SAMEER-MLPROJECT/RoTorBot/docs/figures/09_exploded.png

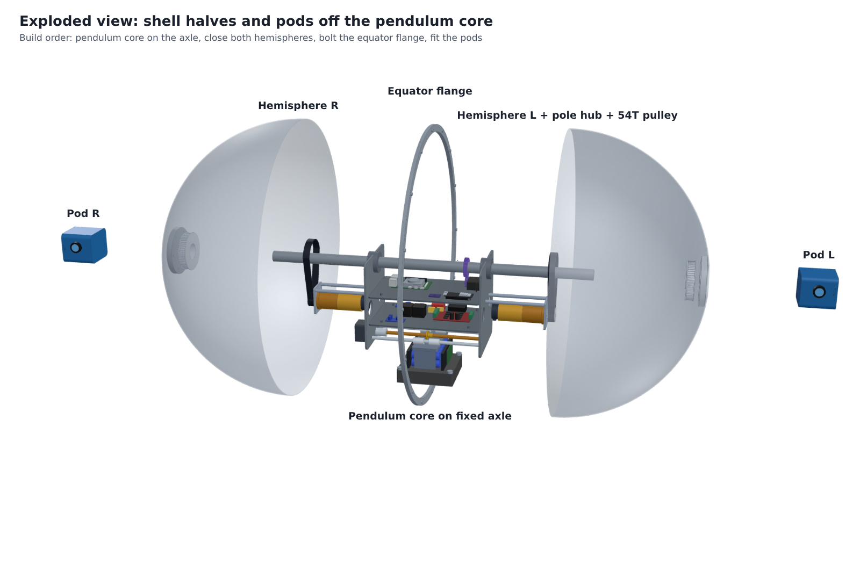
docs/figures/09_exploded.png
