SAMEER-MLPROJECT/RoTorBot/cad/RoToRBot_assembly.step

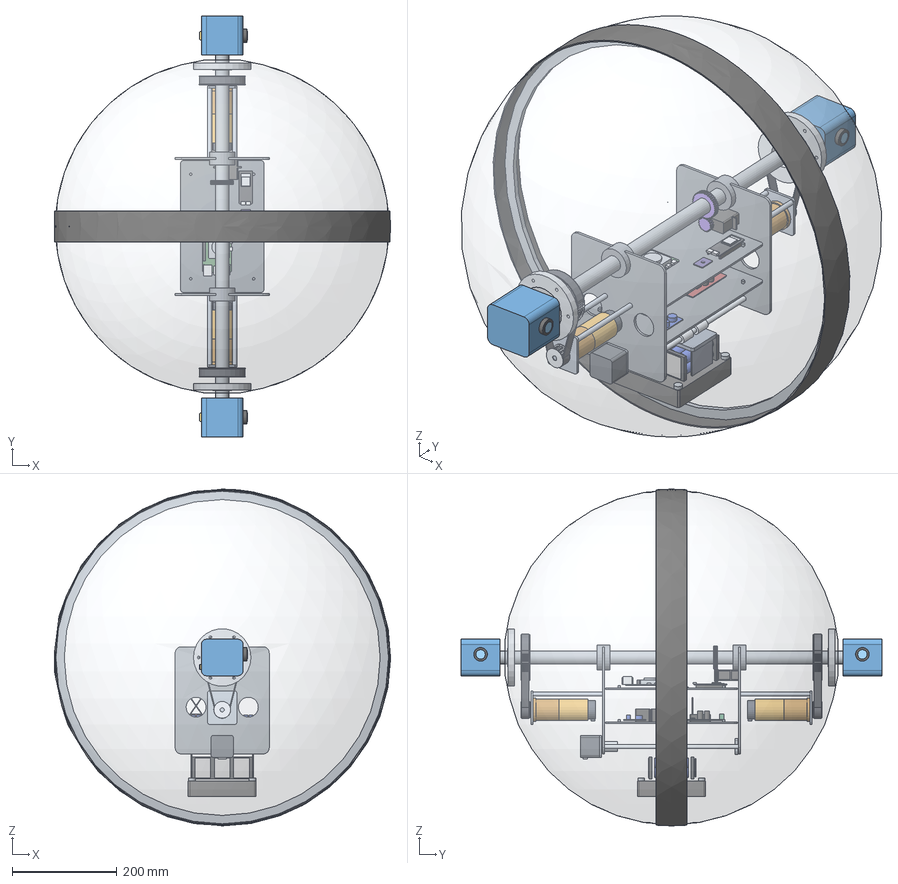
[picture p33: CAD file, 2026-10-25]
cad/RoToRBot_assembly.step
642.9 x 805.0 x 644.0 mm
Shell_hemisphere_L__PC_
Shell_hemisphere_R__PC_
Traction_band_60_mm
Equator_flange_ring___M4_bolts
Pole_hub_L__aluminium_
Pole_hub_L_6805_bearing
Hub_pulley_54T_L_HTD-5M
Pole_hub_R__aluminium_
Pole_hub_R_6805_bearing
Hub_pulley_54T_R_HTD-5M
Fixed_shaft_25_mm_Al_tube
Camera_pod_L
Camera_lens_window_L
Camera_glass_L
Pod_socket_L__arming_plug_
Pod_guard_L
Camera_pod_R
Camera_lens_window_R
Camera_glass_R
Pod_socket_R__charge_port_
Pod_guard_R
Side_plate_L__4_mm_Al
Shaft_clamp_L__axle_bearing_housing_
Side_plate_R__4_mm_Al
Shaft_clamp_R__axle_bearing_housing_
Deck_A__compute_
Deck_B__power_
Raspberry_Pi_5_PCB
Pi_5_active_cooler
Pi_5_USB-A_x2___Ethernet
Pi_5_GPIO_header
Pi_5_USB-C__micro-HDMI
Pi_5_camera_connectors__CSI_x2_
ESP32-S3_DevKitC-1_PCB
ESP32-S3_WROOM-1_module
ESP32-S3_pin_headers
ESP32-S3_USB-C_ports
BNO085_IMU_breakout
Levelling_servo__metal_gear_
Levelling_gear_on_shaft
Levelling_servo_gear
Dual_20_A_motor_driver_PCB
Driver_MOSFETs___capacitors
Driver_terminal_blocks
Buck_24-5_V_5.5_A__logic_
Buck_24-6_V_3_A__servo_
Relays_K1_main___K2_kill__24_V__40_A_
2.4_GHz_kill_receiver
Fuse_holder_25_A
XT60_connectors
TMC2209_stepper_driver
Drive_motor_L_planetary_gearbox
Drive_motor_L_motor_can__775_
Drive_motor_L_encoder_cap
Motor_shaft_L
Motor_pulley_18T_L
HTD-5M_belt_L
Motor_bracket_L__face_plate___standoffs_
Drive_motor_R_planetary_gearbox
Drive_motor_R_motor_can__775_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
