SAMEER-MLPROJECT/RoTorBot/cad/RoToRBot_internals_no_shell.stl

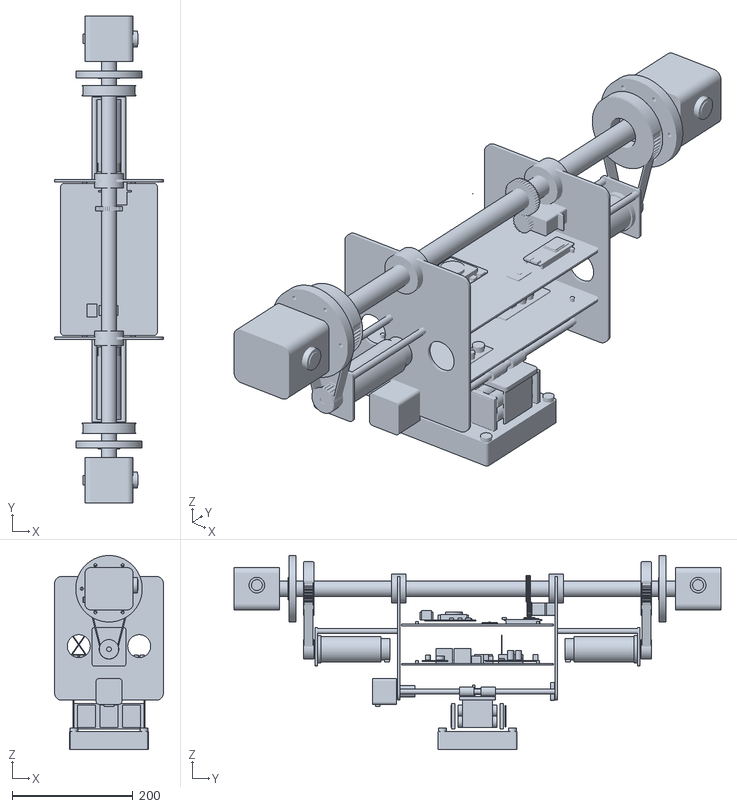
[picture p34: CAD file, 2026-10-25]
cad/RoToRBot_internals_no_shell.stl
180.0 x 805.0 x 321.0
