SAMEER-MLPROJECT/RoTorBot/(list of files, cad)

Other CAD files:
cad/RoToRBot_assembly.stl
