SAMEER-MLPROJECT/RoTorBot/(commit log)

2026-10-25 Refactor comments and clean up pin definitions
2026-10-27 Document ownership and copyright information
    Added section on ownership, authorship, and intellectual property rights for the RoToRBot project.
